ZOUDIO/AIO438/Testfixture/130100-Bottom-WL.dxf

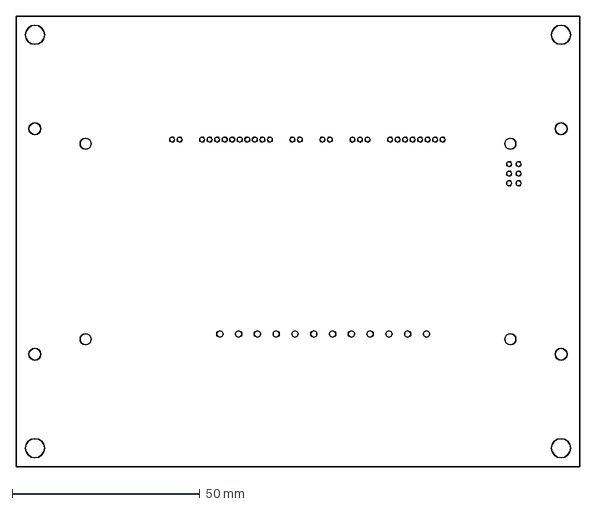
[picture p1: CAD file, 2022-07-18]
Testfixture/130100-Bottom-WL.dxf
150.0 x 120.0 mm
