ZOUDIO/AIO438/Testfixture/130100-Bottom-WLv2.dxf

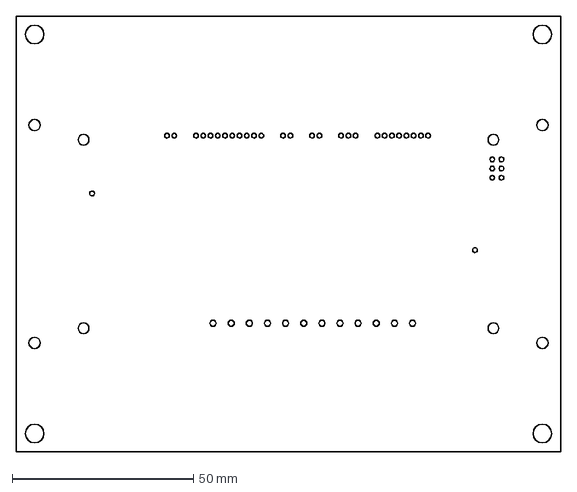
[picture p2: CAD file, 2022-07-18]
Testfixture/130100-Bottom-WLv2.dxf
150.0 x 120.0 mm
