ZOUDIO/AIO438/Testfixture/130100-Top.step

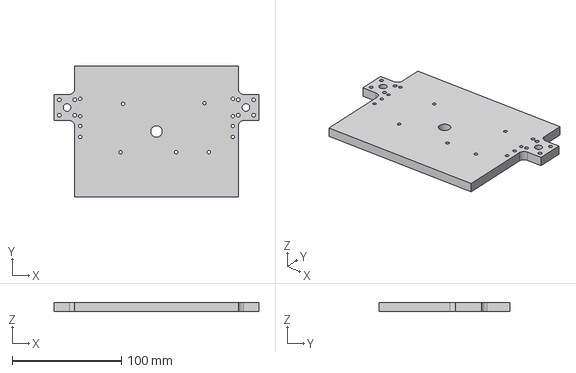
[picture p4: CAD file, 2022-03-13]
Testfixture/130100-Top.step
188.0 x 120.0 x 8.00 mm
