ZOUDIO/AIO438/Testfixture/130100-Middle.step

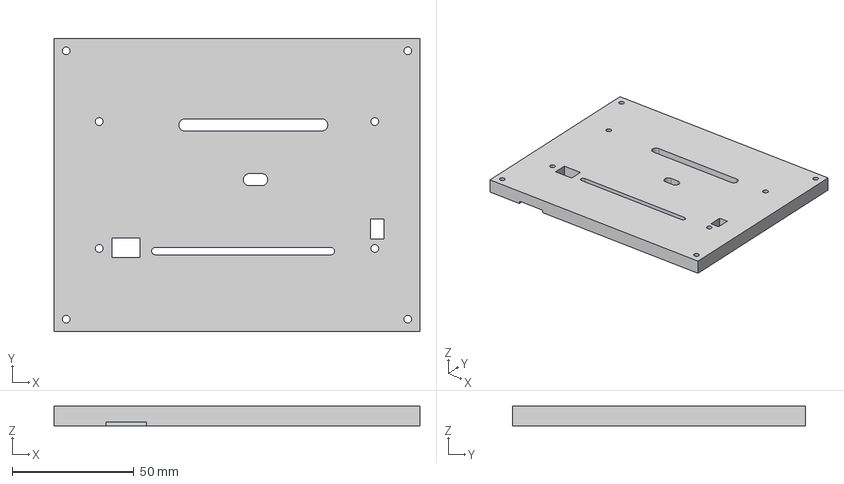
[picture p5: CAD file, 2022-03-13]
Testfixture/130100-Middle.step
150.0 x 120.0 x 8.00 mm
