ZOUDIO/AIO438/(list of files, cad)

Other CAD files:
Testfixture/130100.dwg
