ZOUDIO/AIO438/(commit log)

2021-05-22 Initial files
    First version of the schematic.
    Amp, bt and micro are pretty far.
    Usb hub IC and power structure still require quite some work.
    [AIO438.sch, Amplifiers.sch, Bluetooth.sch, Microcontroller.sch, Miscellaneous.sch, Power.sch, USB to UART.sch, USB.sch]
2021-06-09 Pre refdes fix
    [AIO438.kicad_pcb, AIO438.sch, Amplifiers.sch, Bluetooth.sch, Microcontroller.sch, Miscellaneous.sch, Power.sch, USB to UART.sch]
2021-07-31 V0.1 check
    [AIO438.kicad_pcb, AIO438.sch, Amplifiers.sch, Bluetooth.sch, Microcontroller.sch, Miscellaneous.sch, Power.sch, USB to UART.sch]
2021-08-12 Version 0.1
    [AIO438.kicad_pcb, AIO438.sch, Microcontroller.sch]
2021-08-28 Modify library references
    As described in the README of the newly added libraries submodule.
    Schematic and PCB are synced.
    Hardware folder is renamed to mainboard
    Any other PCBs can be put in their own subfolder in the gitrepo
    Commit also swaps source/drain of Q1 because it appeared wrong for some
    reason after updating all symbol/footprints.
    [AIO438.kicad_pcb, AIO438.sch, Amplifiers.sch, Bluetooth.sch, Microcontroller.sch, Miscellaneous.sch, Power.sch, USB to UART.sch]
2021-11-08 Add USB-C
    [AIO438.kicad_pcb, USB.sch, USB4105-15-A-120.stp]
2021-11-08 Before power tree change
    Backup before switching from two to one LDO
    [AIO438.sch, Amplifiers.sch, Bluetooth.sch, Microcontroller.sch, Miscellaneous.sch, Power.sch, USB to UART.sch, USB.sch]
2021-11-27 Before testing CH340B and VCHG
    Cleaned up amp lay-out a bit in the meanwhile
    [AIO438.kicad_pcb, AIO438.sch, Amplifier.sch, Amplifiers.sch, Bluetooth.sch, Microcontroller.sch, Miscellaneous.sch, Power.sch]
2021-11-28 Result after weekend of lay-out
    Pretty far, just neats to be cleaned up for production.
    Does not pass DRC yet.
    [AIO438.kicad_pcb, AIO438.sch, Amplifier.sch, Amplifiers.sch, Bluetooth.sch, Microcontroller.sch, USB-to-UART.sch, USB.sch]
2021-12-01 Mainboard: Version 1.0
    Still need to clean up 3D models and BoM list,
    but gerberexport-ready and ready to order.
    [AIO438.kicad_pcb, AIO438.sch, Amplifier.sch, Amplifiers.sch, Bluetooth.sch, Microcontroller.sch, Miscellaneous.sch, Power.sch]
2021-12-04 Clean up schematic for BoM export
    - Change 22u 0805's (amp decoupling) to 15u
    - Change 680n 0805's (part of output filter) to 470n
    - Change C1 (amp bulk cap) from 820u to 1000u
    - Add BoM.ini for KiBom export and
    - Complete fields needed for KiBom (Manufacturer and partnumber)
    [Amplifier.sch, Amplifiers.sch, Bluetooth.sch, Microcontroller.sch, Miscellaneous.sch, Power.sch, USB to UART.sch, USB-to-UART.sch]
2022-02-09 Update gitignore for KiCad 6
    Ignores -backups folder
    Ignores new schematic and layout file extensions
    Ignores .kicad_prl (project local) file
2022-02-09 Update project to Kicad 6
    Convert schematic and layout
    Remove all other redundant files
    [AIO438.kicad_pcb, AIO438.kicad_sch, AIO438.sch, Amplifier.kicad_sch, Amplifier.sch, Amplifiers.kicad_sch, Amplifiers.sch, Bluetooth.kicad_sch]
2022-02-09 Update lay-out and fix legacy 3d models
    Update lay-out from schematic
    Add legacy 3d model searchpath KISYS3DMOD
    [AIO438.kicad_pcb]
2022-02-09 Do board setup and clear any DRC errors
    Only DRC error left remaining is related to the antenna.
    Library setup is still broken right now.
    [AIO438.kicad_pcb, AIO438.kicad_sch, Bluetooth.kicad_sch]
2022-02-09 Move mainboard from root to PCB folder
    [AIO438.kicad_pcb, AIO438.kicad_sch, Amplifier.kicad_sch, Amplifiers.kicad_sch, Bluetooth.kicad_sch, Microcontroller.kicad_sch, Miscellaneous.kicad_sch, Power.kicad_sch]
2022-02-09 Update kicad libraries
    Remove Kicad 5 libraries from root
    Add Kicad 6 libraries to /PCB/.
2022-02-10 Update schematic and lay-out
    - Swap out CP2102N, ATmega328PB and CP with new Kicad 6 symbol
    - Correct all links to point to new zoudio_symbols and zoudio_footprint libraries
    - Lay-out updated, only antenna is left to update.
    [AIO438.kicad_pcb, AIO438.kicad_sch, Amplifier.kicad_sch, Amplifiers.kicad_sch, Bluetooth.kicad_sch, Microcontroller.kicad_sch, Miscellaneous.kicad_sch, Power.kicad_sch]
2022-02-10 Tie FE1.1S BUSJ pin to 3V3 instead of GND
    To indicate chip is self-powered instead of bus-powered
    With updated lay-out
    [AIO438.kicad_pcb, AIO438.kicad_sch, Amplifier.kicad_sch, USB.kicad_sch]
2022-02-12 Add buck, change some part values
    Add new buck in schematic and layout.
    Modify BT module footprint,
    Change power led resistor from 1k to 100R
    Change 4.7u TAS resistors to 10u (consolidation)
    [AIO438.kicad_pcb, AIO438.kicad_sch, Amplifier.kicad_sch, Microcontroller.kicad_sch, Power.kicad_sch, User-controls.kicad_sch]
2022-02-12 Mainboard: Version 1.1
    Modified data and version number on all schematic sheet
    Modified version number in silkscreen
    Filled zones and exported
    [AIO438.kicad_pcb, AIO438.kicad_sch, Amplifier.kicad_sch, Amplifiers.kicad_sch, Bluetooth.kicad_sch, Microcontroller.kicad_sch, Miscellaneous.kicad_sch, Power.kicad_sch]
2022-02-12 Import AIO4CH_CONN files
    Unchanged, kicad 5 files.
    Contains the leds, rotary encoder and 3.5mm jack.
    [AIO4CH_CONN.kicad_pcb, AIO4CH_CONN.sch]
2022-02-12 Convert AIO4CH_conn to kicad 6
    And rename to AIO_IO_board
    [AIO4CH_CONN.kicad_pcb, AIO4CH_CONN.sch, AIO_IO_board.kicad_pcb, AIO_IO_board.kicad_sch]
2022-02-13 AIO_IO_board single board
    [AIO_IO_board.kicad_pcb, AIO_IO_board.kicad_sch]
2022-02-15 AIO_IO_board single board with tabs instead of mousebites
    [AIO_IO_board.kicad_pcb]
2022-02-15 AIO_IO_board with tabs panelized
    [AIO_IO_board.kicad_pcb]
2022-02-21 Mainboard: update symbol fields for bom export
    [Amplifier.kicad_sch, Microcontroller.kicad_sch, Power.kicad_sch, User-controls.kicad_sch]
2022-02-22 AIO438-firmware: Make everything snake-case
2022-02-22 AIO438-firmware: Before I2C overhaul
    Changes include all kinds of improvements
    Mainly in the binary command handler structure
2022-02-22 AIO438-firmware: After I2C overhaul
    Quite some functions consolidated.
    Better structure, although there is some polishing left to do.
2022-02-22 AIO438-firmware: CRC and I2C fixes
    Semi-clean, needs to be tested still
    [AIO438-firmware.ino]
2022-02-22 AIO438-firmware: Add name to entry_struct, improve entry report
    And some other fixes
    [AIO438-firmware.ino]
2022-02-22 AIO438-firmware: Version 1.0.0-RC2
    Includes function code 4 to request runtime crc's.
    Stored CRC does not always reflect actual data (missing/corrupt etc)
    DSP loading is now actually enabled.
    Runtime vars are restored after applying settings.
    Seems to work well, might need some cleaning.
    [AIO438-firmware.ino]
2022-02-22 QCC3031-firmware: Version 1.0.0
    A lot of stuff is still disabled.
    LEDs are instable.
    But BT streaming and analog are working fine.
    Fine for now, LFG.
2022-02-22 AIO438-firmware: Version 2.0.0
    - Removed the incrementation of the burst amount during DSP loading
    The amount (register plus data bytes) now conforms with the TI standard
    - Runtime CRC removed
    This implementation was broken and incomplete.
    For this feature to work a new firmware has to be released later down the road anyway.
    [AIO438-firmware.ino]
2022-02-22 AIO438-firmware: Version 2.0.1
    Fix: tws_monitor triggered on rot_button.clicks() instead of tws_button.clicks()
    [AIO438-firmware.ino]
2022-03-13 Add production flowchart
    First draft
2022-03-13 Add testfixture files
    STEP files of the bottom/middle/top plates that are made in Fusion360
    Based on the DWG basefile received via WeChat.
    [130100-Bottom.step, 130100-Middle.step, 130100-Top.step, 130100.dwg]
2022-04-26 Mainboard: version 1.1.1
    - No change in electrical connectivity
    - Make 3D model more complete
    - Improvements in paste layer for manufacturability
    [AIO438.kicad_pcb, AIO438.kicad_sch, Amplifier.kicad_sch, Amplifiers.kicad_sch, Bluetooth.kicad_sch, Microcontroller.kicad_sch, Miscellaneous.kicad_sch, Power.kicad_sch]
2022-04-26 Correct BTM331 type to SMD
    Was: THT
    So did not appear in position list
    [AIO438.kicad_pcb]
2022-04-26 Remove DNP from J3 config field, add partnumber
    Header is currently populated in assembly
    Add manufacturer and partnumber field
    [Microcontroller.kicad_sch]
2022-04-30 Mainboard: version 1.1.2
    Add testpoints for power rail testing
    Move backside info and logo from mask to silkscreen
    [AIO438.kicad_pcb, AIO438.kicad_sch, Amplifier.kicad_sch, Amplifiers.kicad_sch, Bluetooth.kicad_sch, Microcontroller.kicad_sch, Miscellaneous.kicad_sch, Power.kicad_sch]
2022-05-04 AIO438-Mainboard-TPCB: Version 0.1
    Uses MTM USB Stem
    Including onboard dummy loads
    Including 24V load switch with current sense
    [AIO438.kicad_pcb, AIO438.kicad_sch, dummy_load.kicad_sch, load_sw.kicad_sch, mainboard.kicad_sch, misc.kicad_sch, mtm.kicad_sch, power.kicad_sch]
2022-07-18 Add fixture bottom plates
    First ones is with slots
    v2 is with holes, for Ingun WL series probes
    [130100-Bottom-WL.dxf, 130100-Bottom-WLv2.dxf]
2022-07-18 TPCB files V2
    [AIO438-pogo-guide.kicad_pcb, AIO438.kicad_pcb, AIO438.kicad_sch, dummy_load.kicad_sch, mainboard.kicad_sch, misc.kicad_sch, mtm.kicad_sch, power.kicad_sch]
